ArtemSolovyev/-/Приложение 3.5.jpg

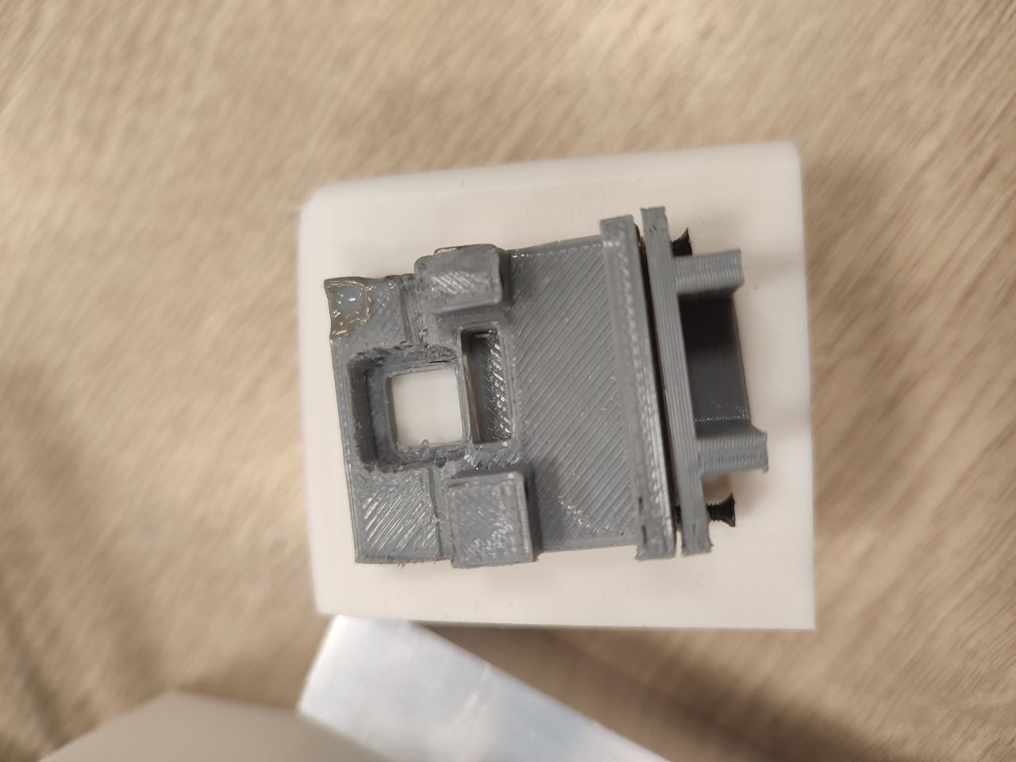
Приложение 3.5.jpg
