ArtemSolovyev/-/Приложение 3.1.jpg

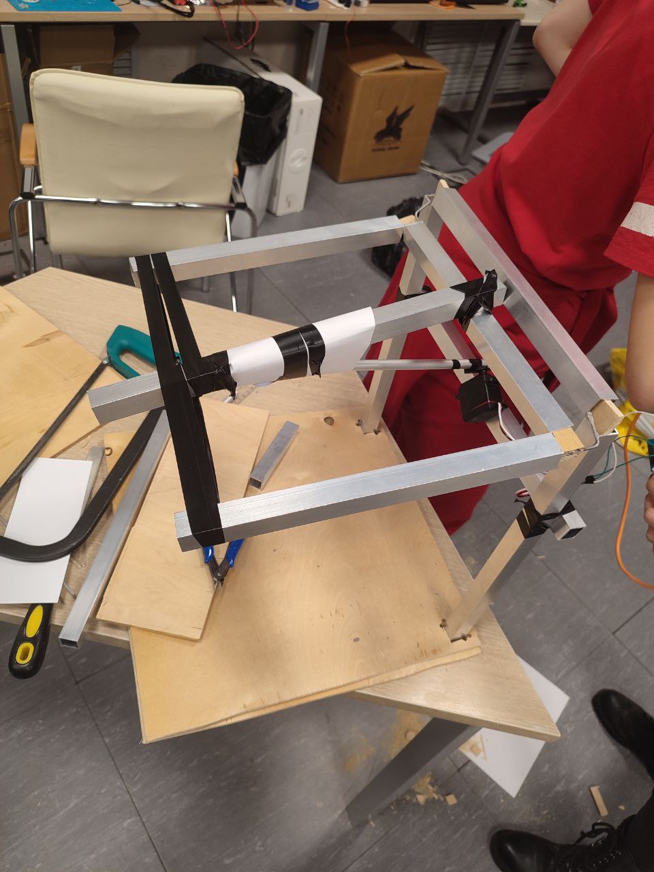
Приложение 3.1.jpg
