ArtemSolovyev/-/README.md

"# -" 
Проект теплица для предпроф олимпиады (кейс 7)
