ArtemSolovyev/-/3.png

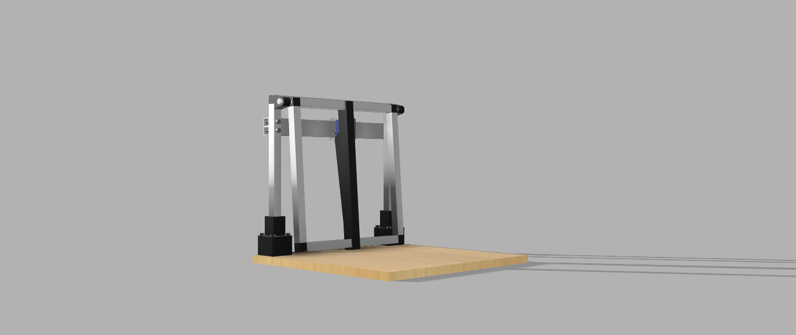
3.png
