ArtemSolovyev/-/11.png

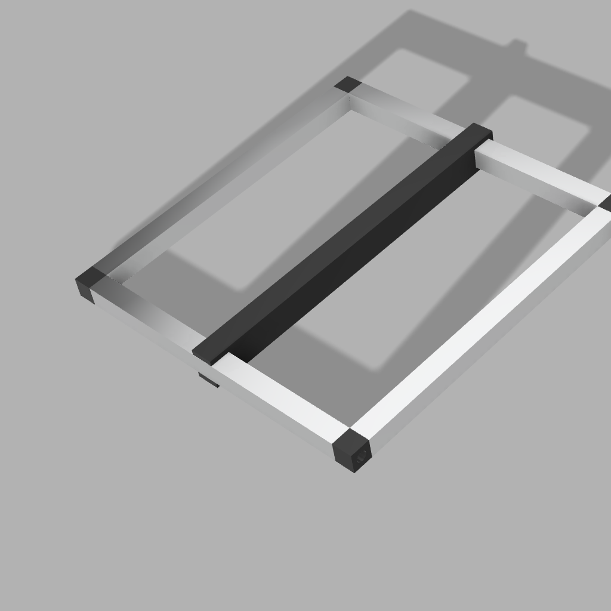
11.png
