ArtemSolovyev/-/22.png

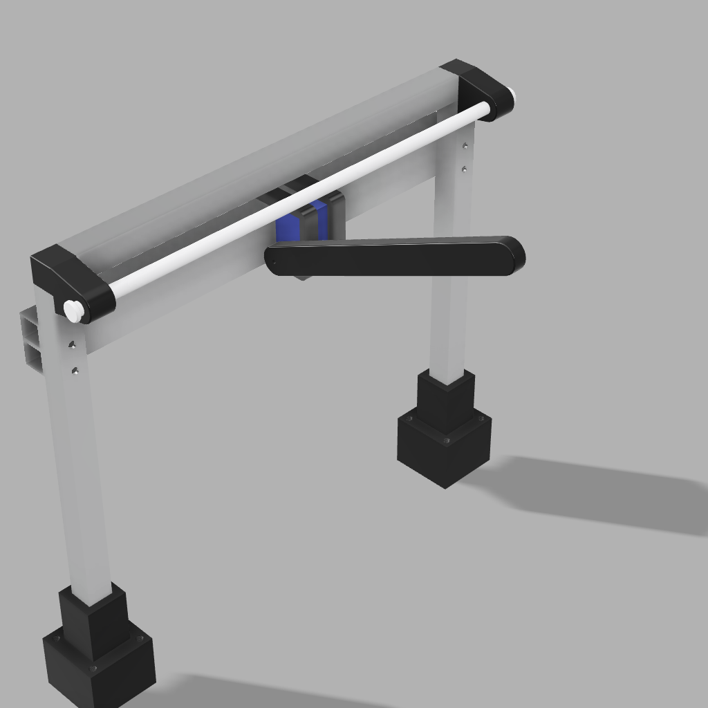
22.png
