ArtemSolovyev/-/33 (1).png

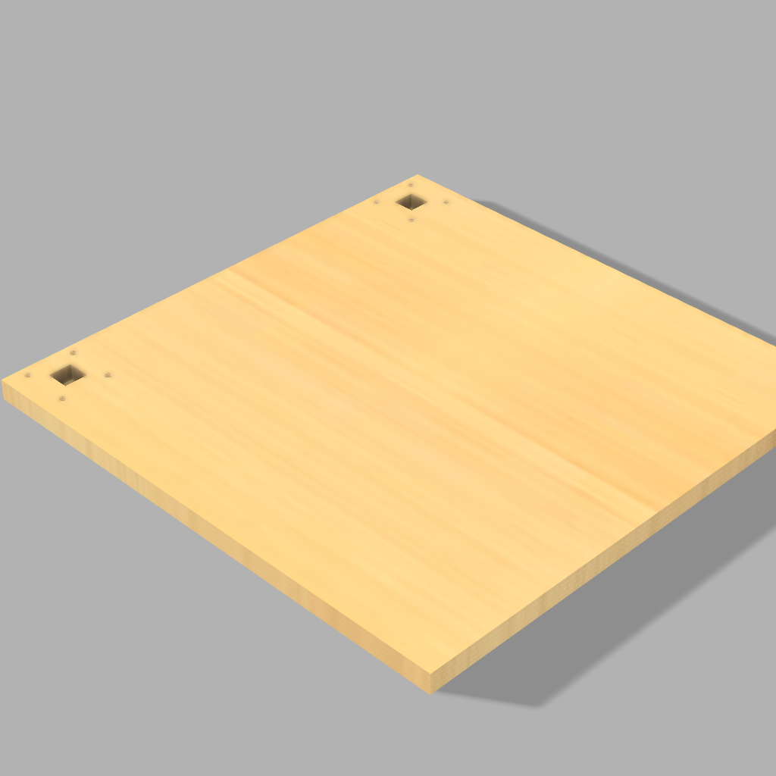
33 (1).png
