ArtemSolovyev/-/Pompa_МП (2).png

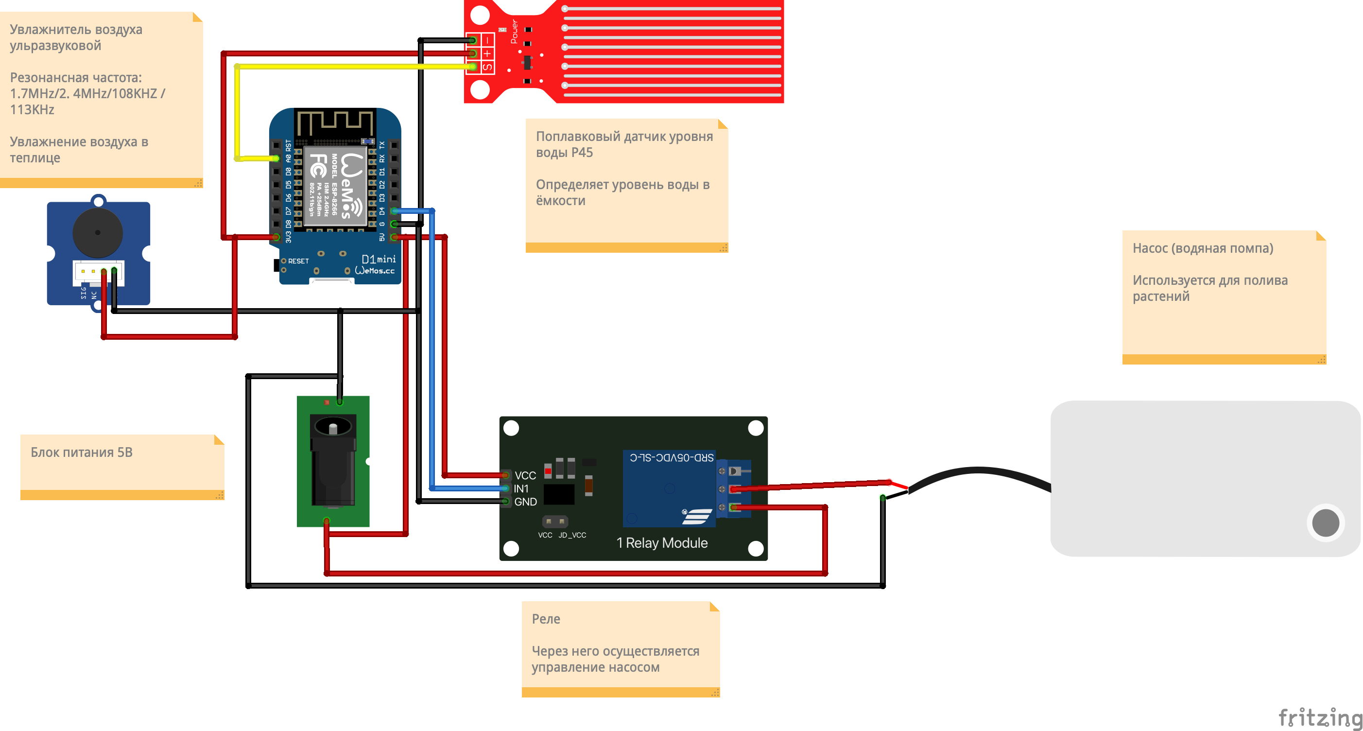
Pompa_МП (2).png
