ArtemSolovyev/-/Pompa_схема (1).png

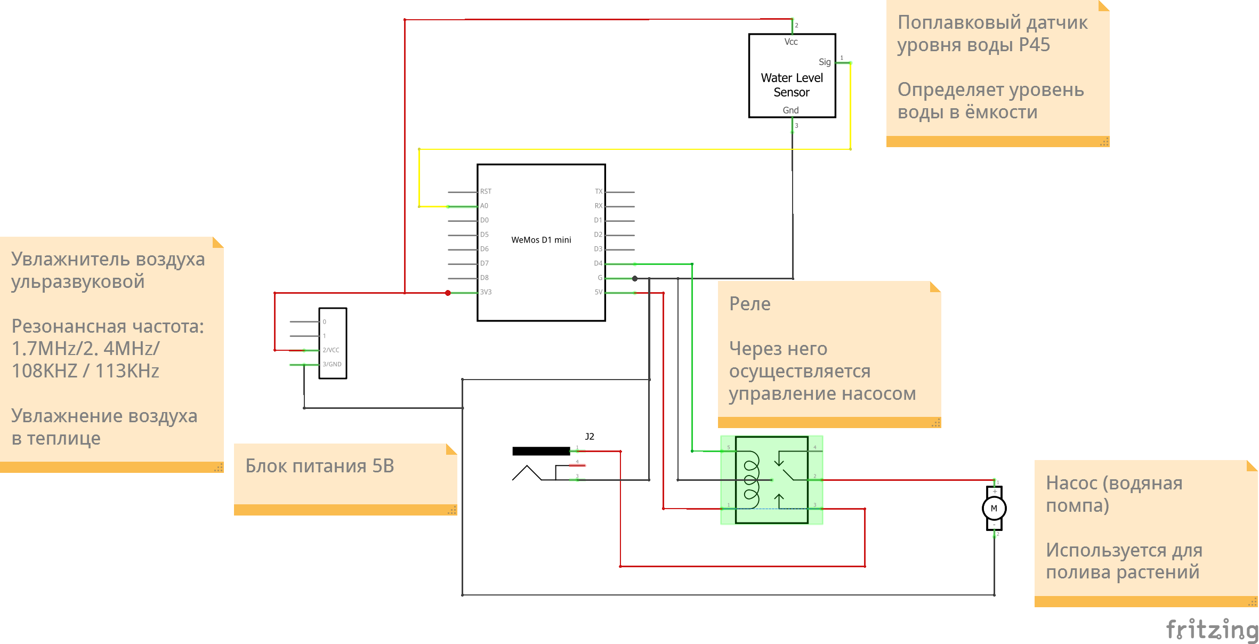
Pompa_схема (1).png
