ArtemSolovyev/-/Блок схемы.png

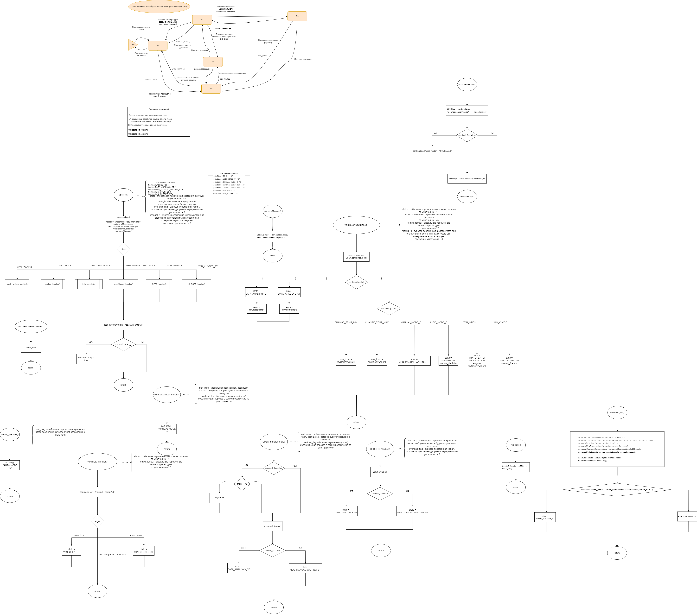
Блок схемы.png
