ArtemSolovyev/-/Датчик почвы и воздуха_МП .png

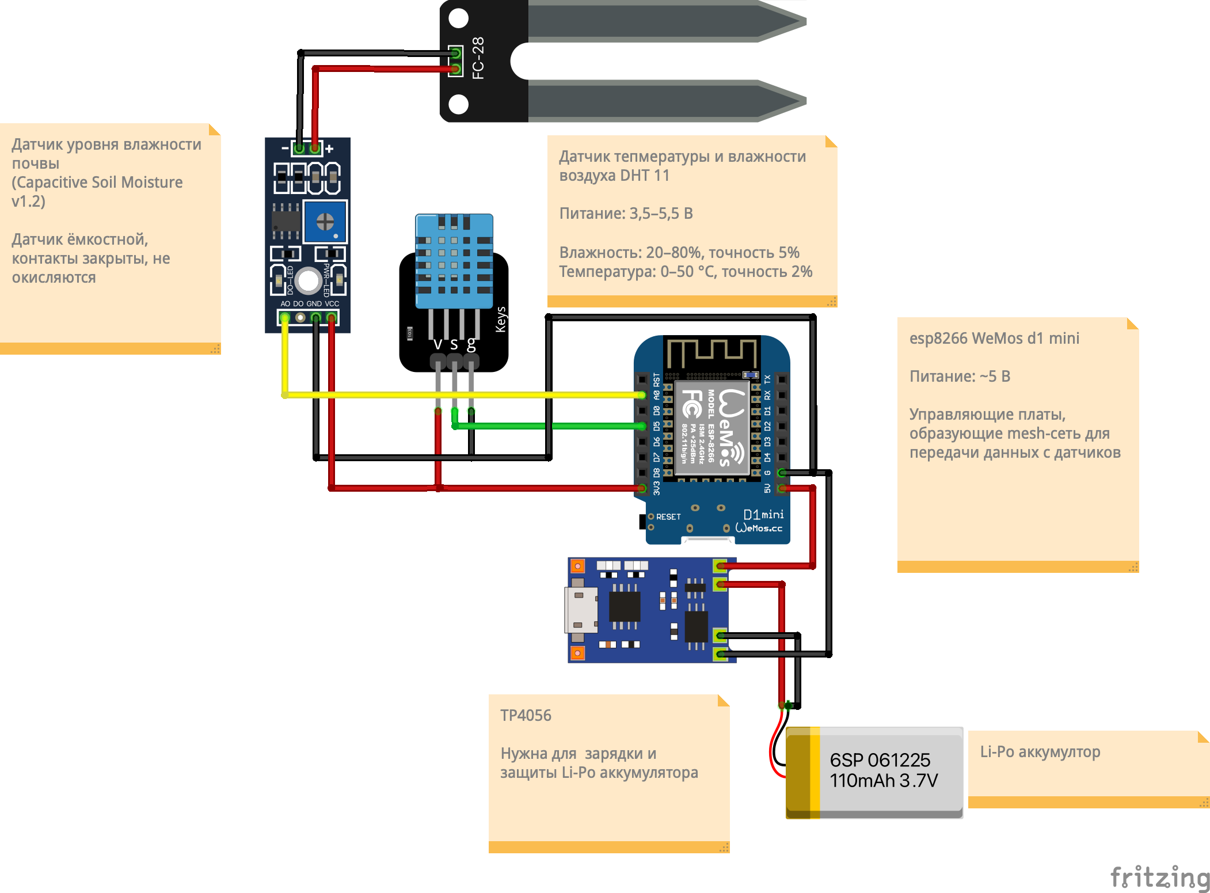
Датчик почвы и воздуха_МП .png
