ArtemSolovyev/-/Датчик почвы и воздуха_схема .png

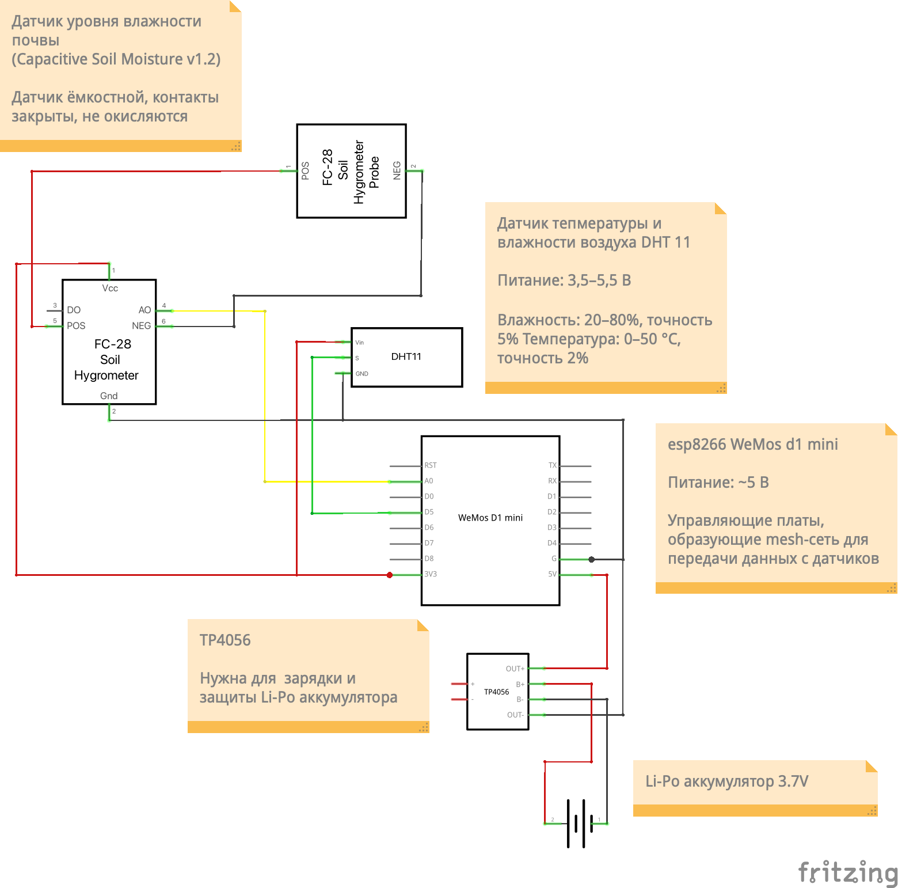
Датчик почвы и воздуха_схема .png
