ArtemSolovyev/-/Панель управления_МП.png

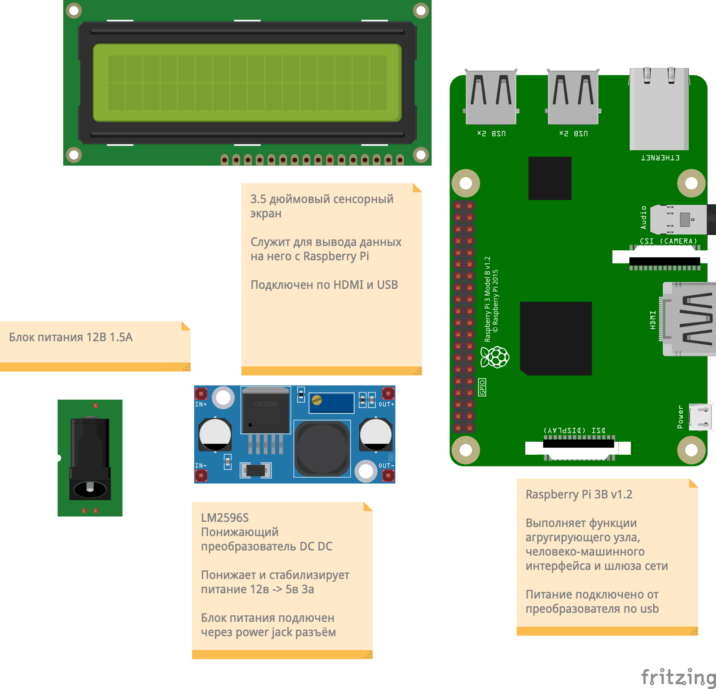
Панель управления_МП.png
