ArtemSolovyev/-/Панель управления_схема .png

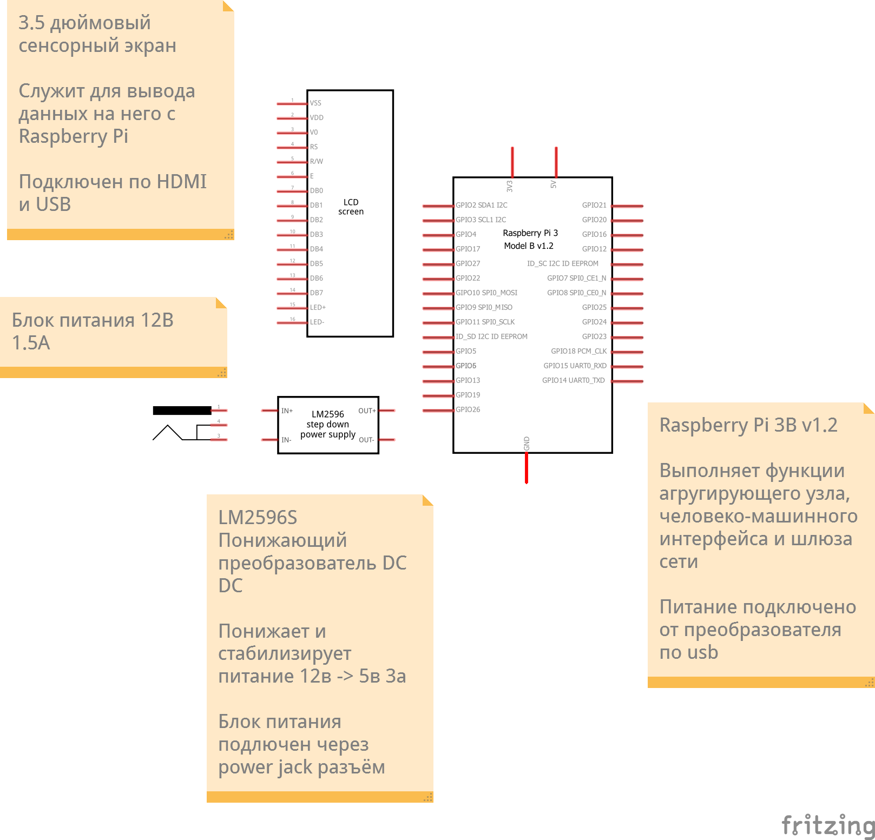
Панель управления_схема .png
