ArtemSolovyev/-/Приложение 1.1.jpg

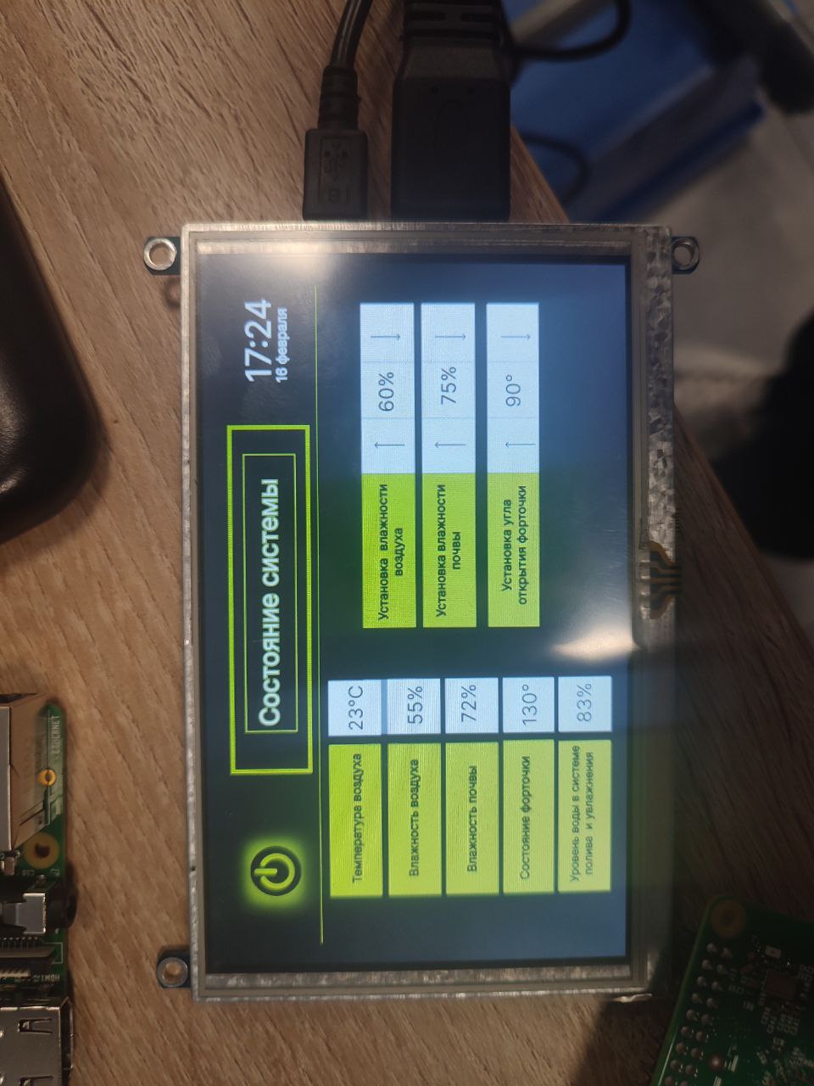
Приложение 1.1.jpg
