ArtemSolovyev/-/Приложение 1.2.jpg

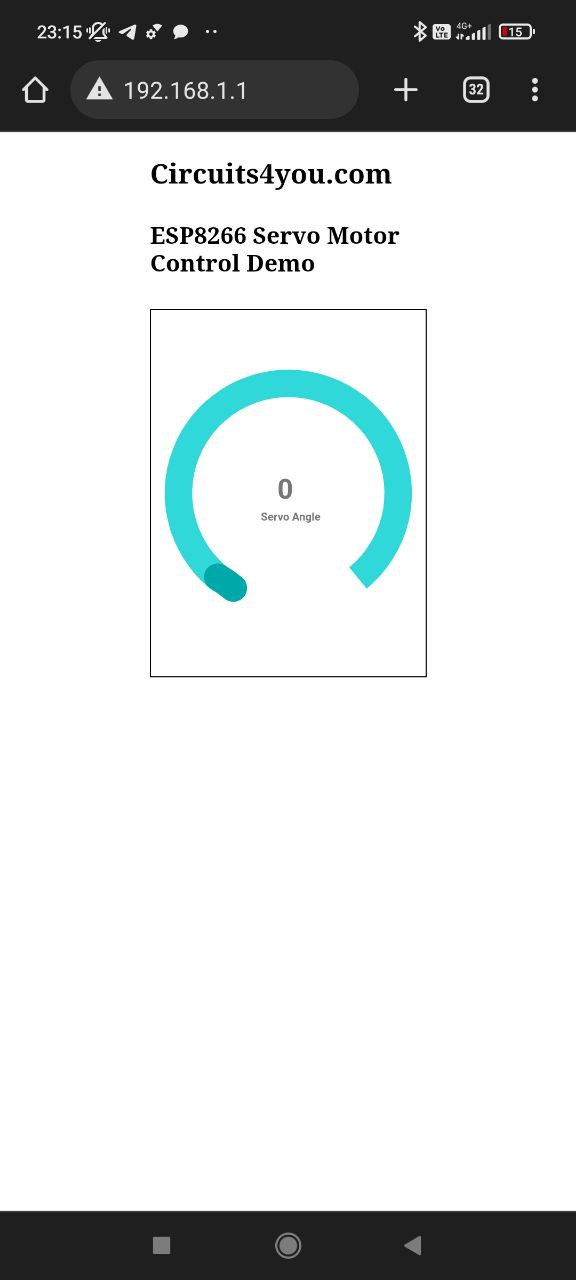
Приложение 1.2.jpg
