ArtemSolovyev/-/Приложение 1.3.jpg

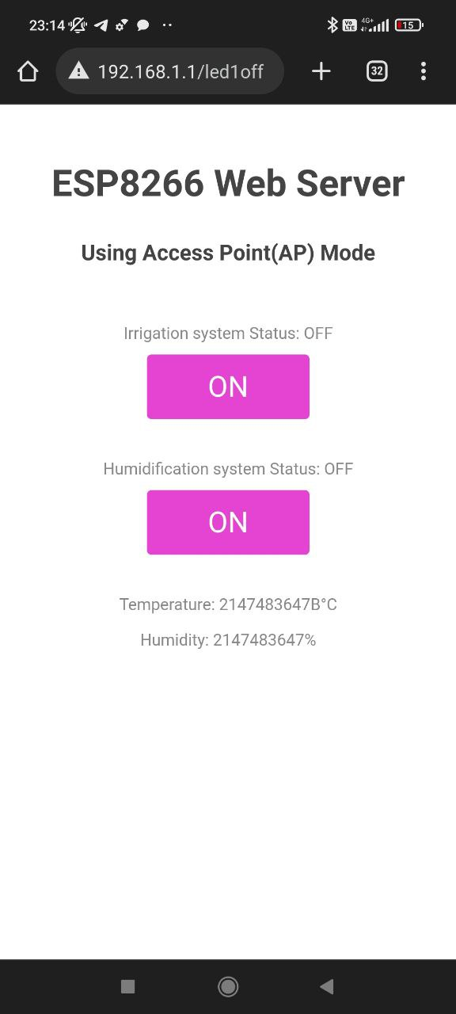
Приложение 1.3.jpg
