ArtemSolovyev/-/Приложение 3.2.jpg

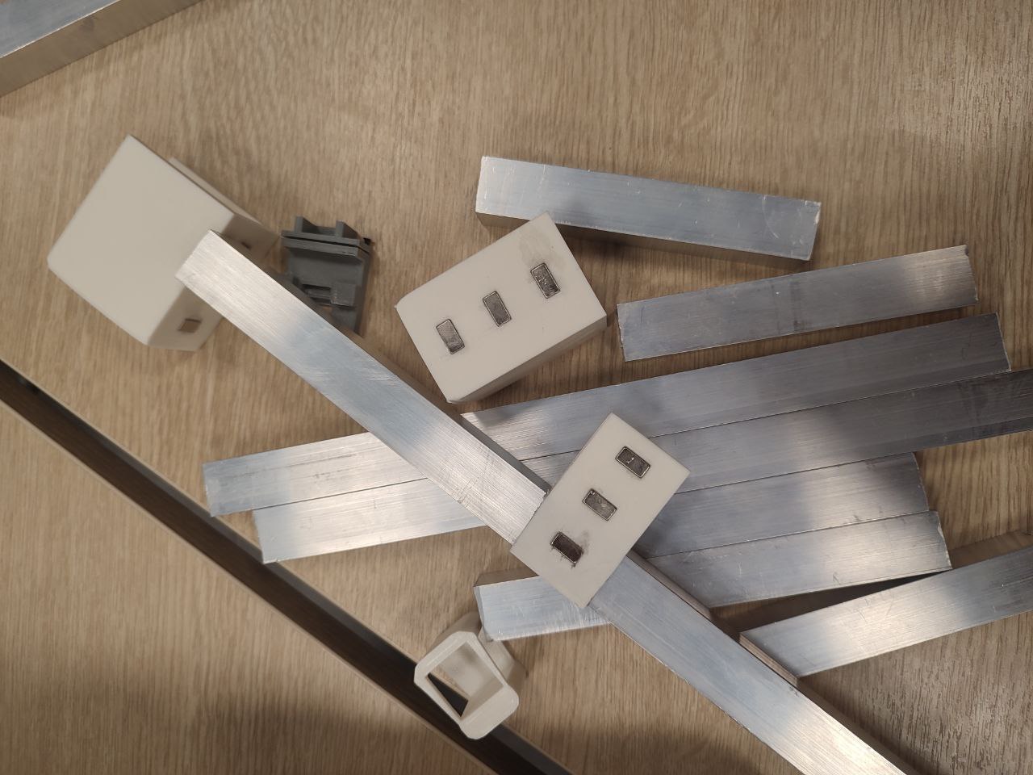
Приложение 3.2.jpg
