ArtemSolovyev/-/Приложение 3.3.jpg

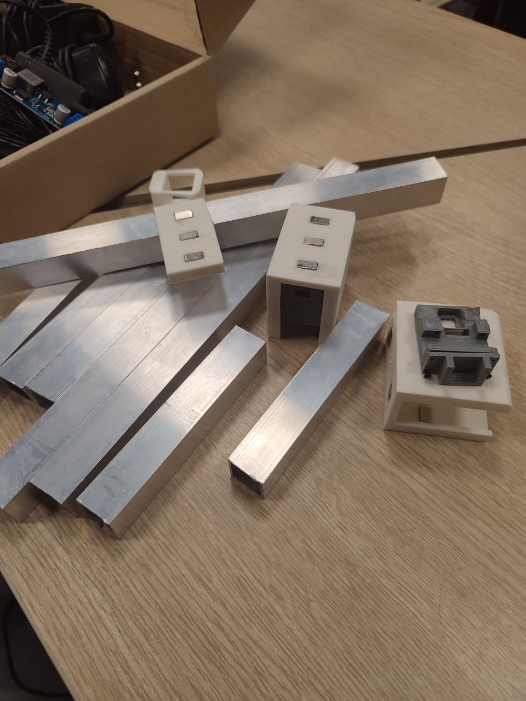
Приложение 3.3.jpg
