ArtemSolovyev/-/Приложение 3.4.jpg

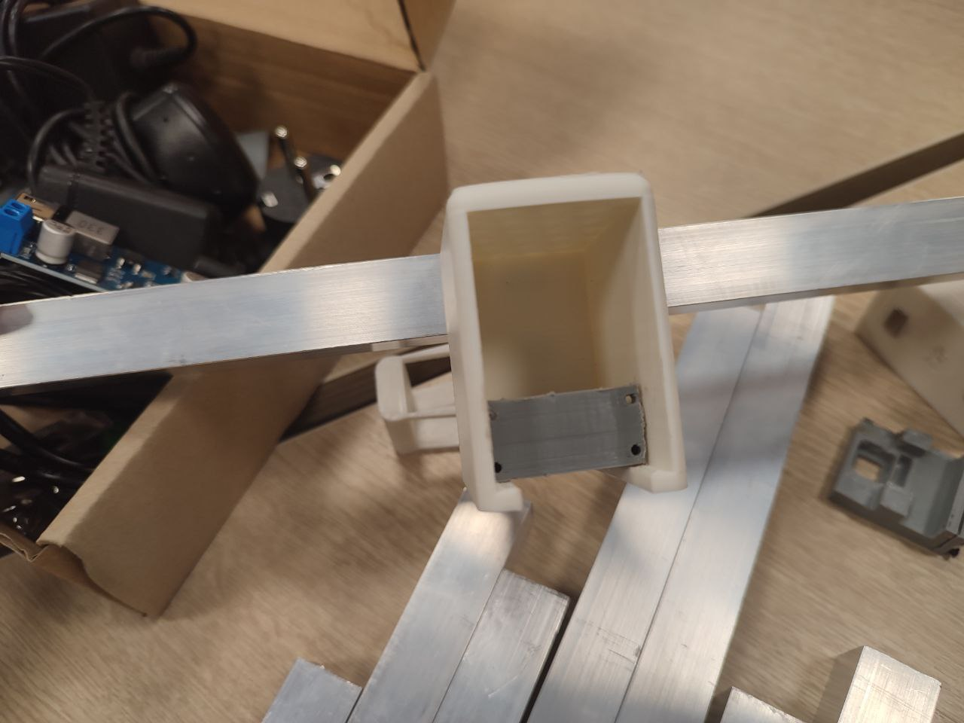
Приложение 3.4.jpg
