ArtemSolovyev/-/т1.png

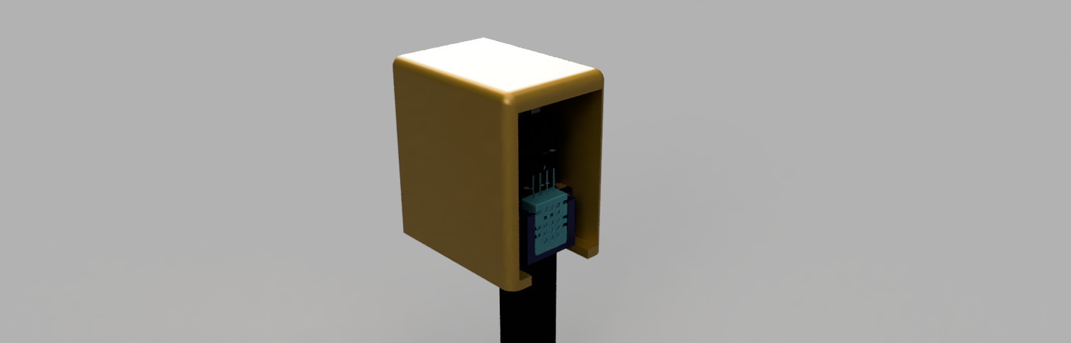
т1.png
