ArtemSolovyev/-/т2.png

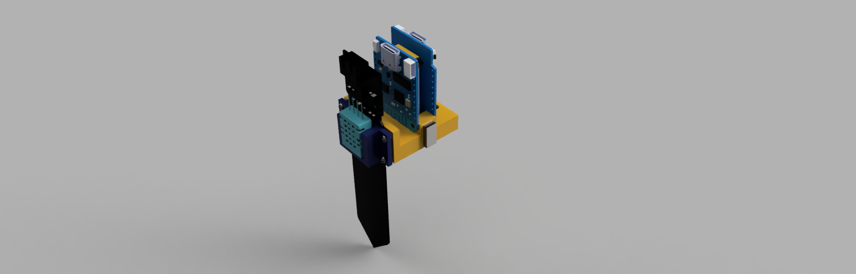
т2.png
