ArtemSolovyev/-/т3.png

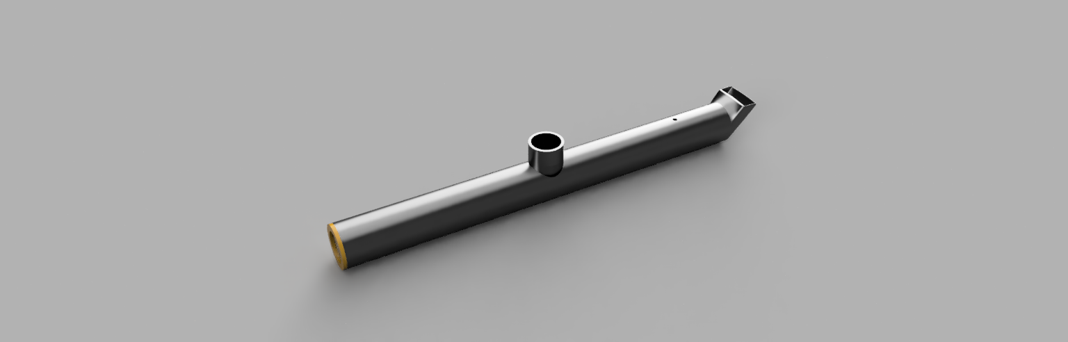
т3.png
