ArtemSolovyev/-/т4.png

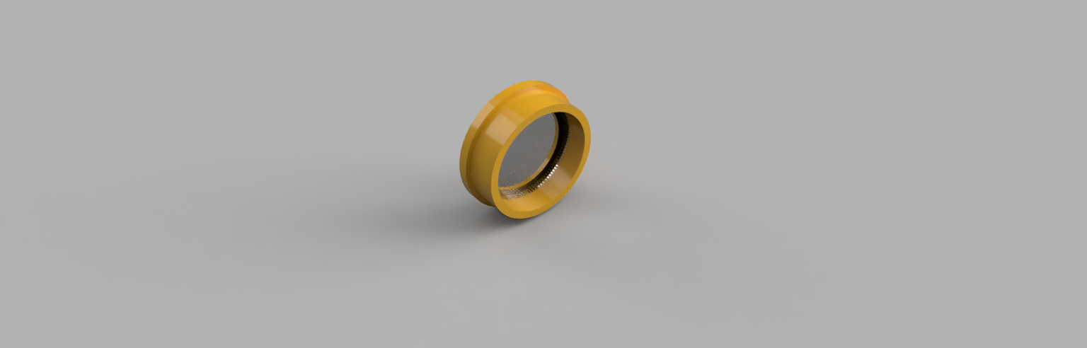
т4.png
