ArtemSolovyev/-/т5.png

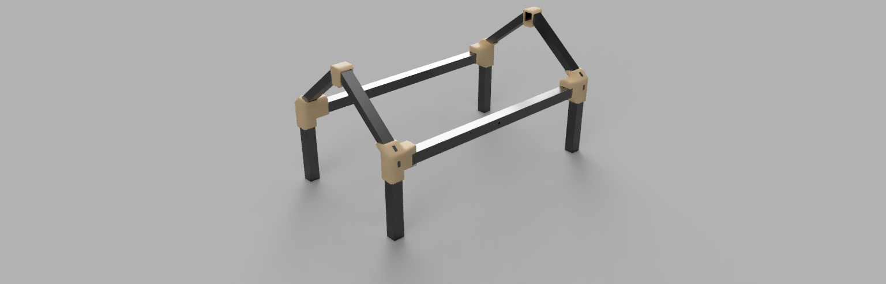
т5.png
