ArtemSolovyev/-/т6.png

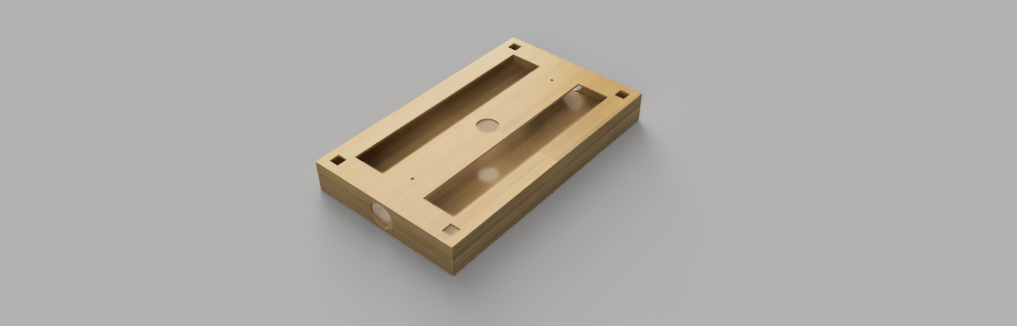
т6.png
