ArtemSolovyev/-/т7.png

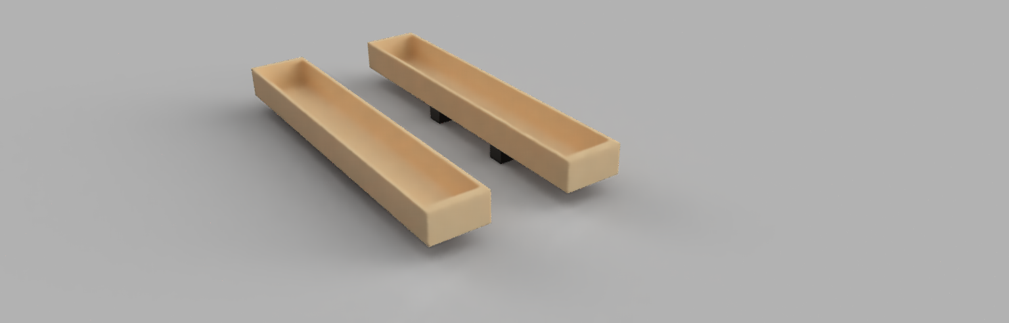
т7.png
