ArtemSolovyev/-/Форточка (1).png

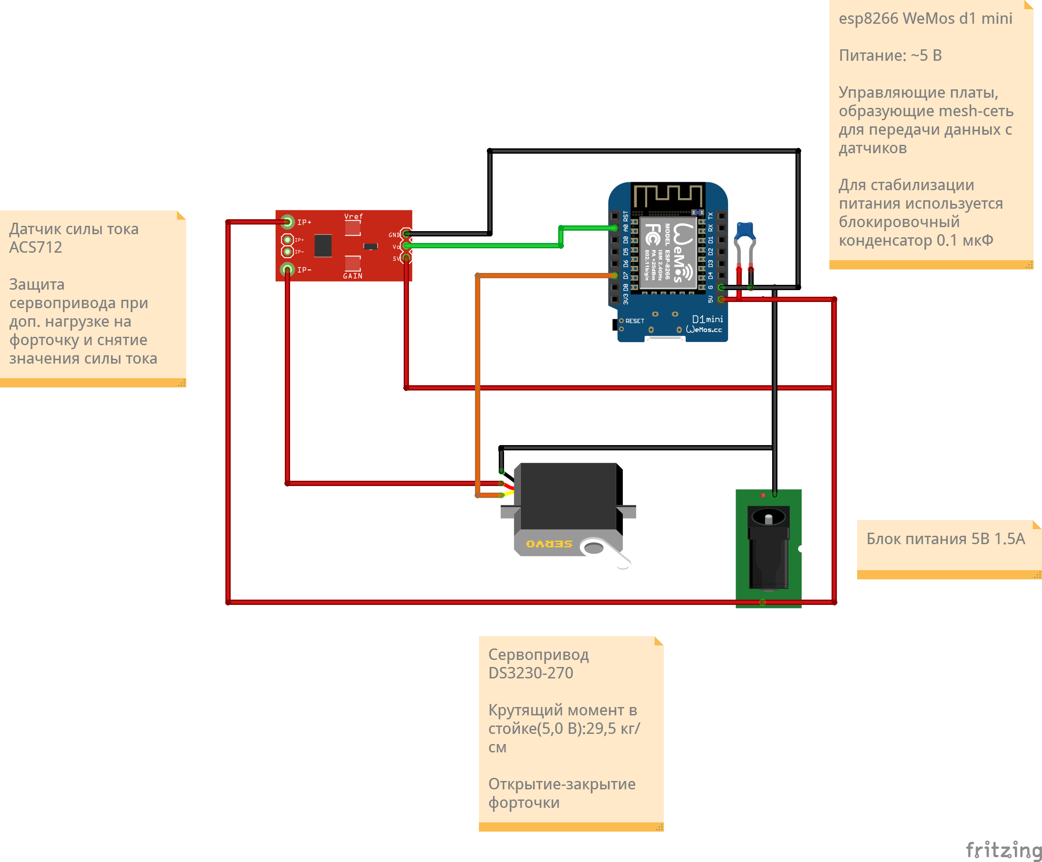
Форточка (1).png
