ArtemSolovyev/-/Форточка_схема (1).png

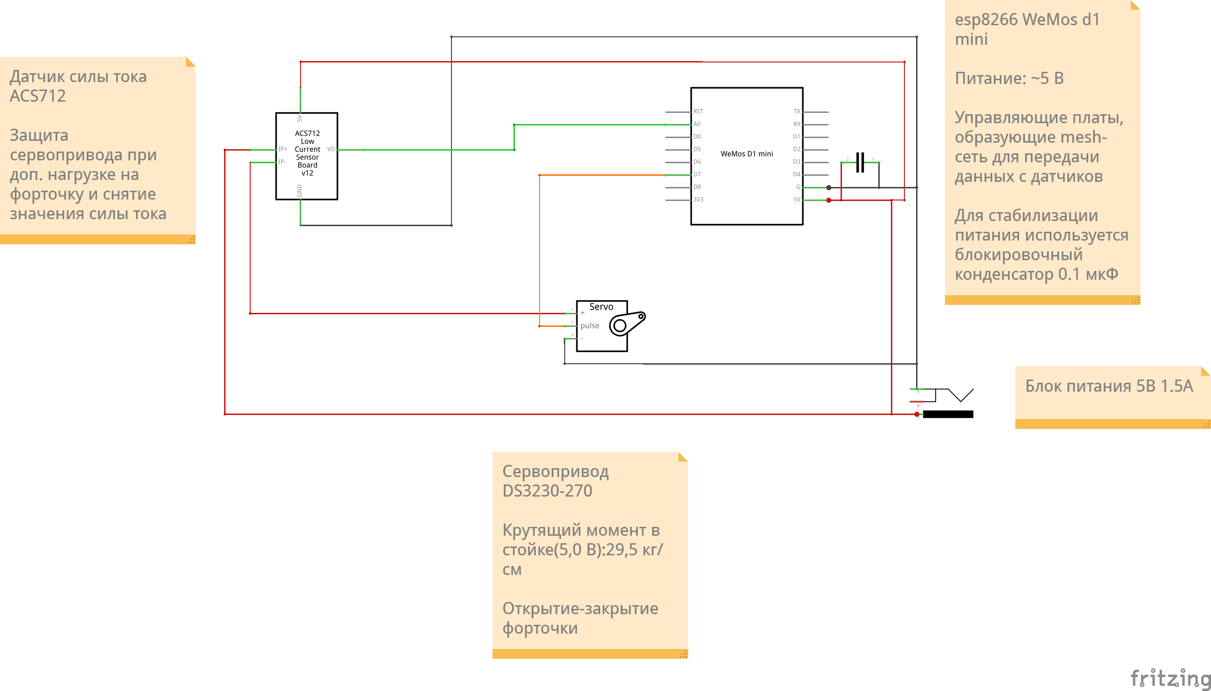
Форточка_схема (1).png
