ArtemSolovyev/-/(list of files, cad)

Other CAD files:
Чертёж.dwg
